beauticode/ProgammableDigitalDisplay/media/photo.jpg

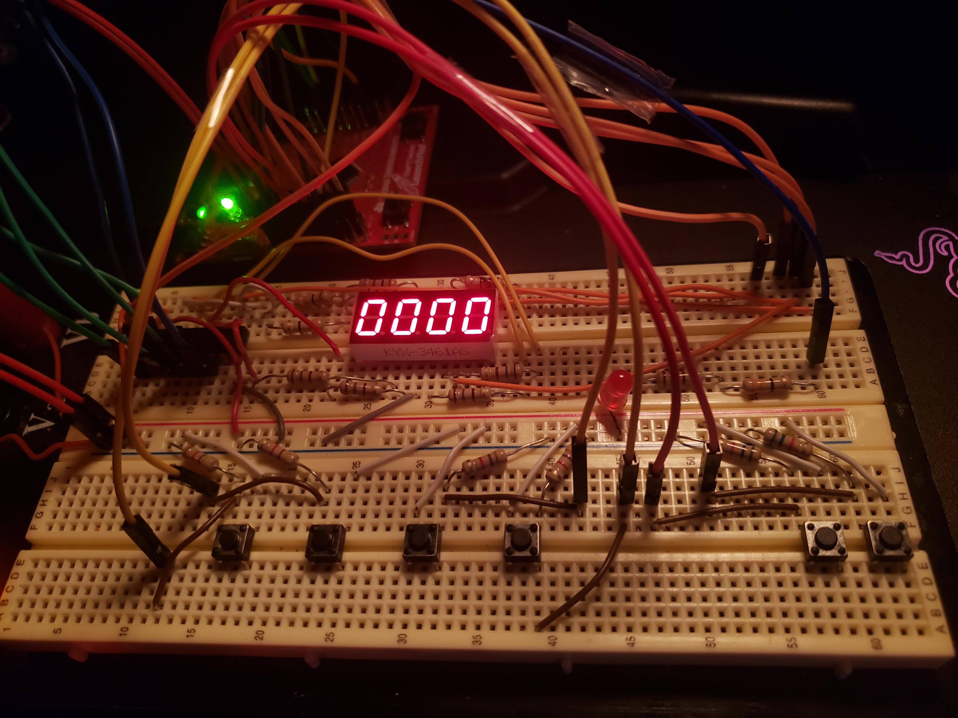
media/photo.jpg
