beauticode/ProgammableDigitalDisplay/README.md

# ProgammableDigitalDisplay
A 4-digit 7-segment display with ability to scroll through characters a-z/0-9 (via buttons) and save each set to be played back in sequence. Utilized the ARM Cortex M4 mcu on the Tiva C Launchpad dev board. Embedded C code and schematic included.
See PDDProject.pdf for detailed info.
Video: https://www.youtube.com/watch?v=TJX261i9BM8
