beauticode/ProgammableDigitalDisplay/schematic/schematic_wdriver.sch

## EAGLE design schematic/schematic_wdriver.sch (2021-03-07)

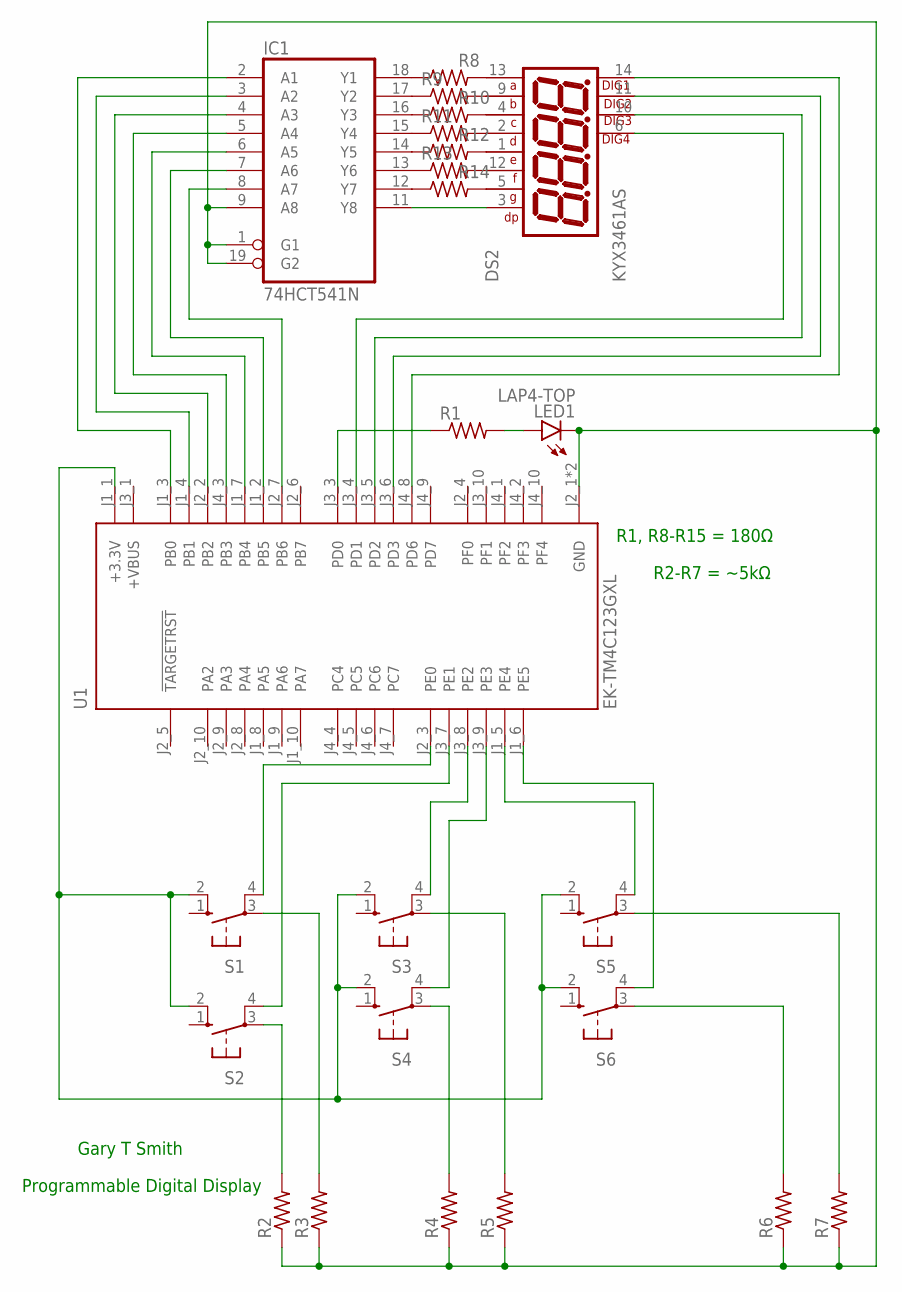
[picture p4: schematic schematic_wdriver.sch]

Parts:
DS2: KYX3461AS; DISPLAY_KYX3461AS
IC1: 74HCT541N; DIL20
LED1: LAP4-TOP; P47F-TOP
R1, R2, R3, R4, R5, R6, R7, R8, R9, R10, R11, R12, R13, R14: R-US_0204/2V; 0204V
S1, S2, S3, S4, S5, S6: 10-XX; B3F-10XX
U1: EK-TM4C123GXL; MODULE_EK-TM4C123GXL

Connections:
unnamed: IC1.18 (Y1), R8.1
unnamed: R1.1, U1.J3_3 (PD0)
unnamed: IC1.8 (A7), U1.J2_7 (PB6)
unnamed: IC1.13 (Y6), R13.1
unnamed: IC1.6 (A5), U1.J1_7 (PB4)
unnamed: IC1.5 (A4), U1.J4_3 (PB3)
unnamed: IC1.4 (A3), U1.J2_2 (PB2)
unnamed: IC1.3 (A2), U1.J1_4 (PB1)
unnamed: DS2.12 (F), R13.2, R14.1
unnamed: DS2.6 (DIG4), U1.J3_4 (PD1)
unnamed: DS2.10 (DIG3), U1.J3_5 (PD2)
unnamed: DS2.11 (DIG2), U1.J3_6 (PD3)
unnamed: DS2.14 (DIG1), U1.J4_8 (PD6)
unnamed: LED1.A, R1.2
unnamed: DS2.5 (G), IC1.12 (Y7), R14.2
unnamed: S6.4 (P1), U1.J1_6 (PE5)
unnamed: S1.2 (S1), S2.2 (S1), S3.2 (S1), S4.2 (S1), S5.2 (S1), S6.2 (S1), U1.J1_1 (+3.3V)
unnamed: S5.4 (P1), U1.J1_5 (PE4)
unnamed: S1.4 (P1), U1.J2_3 (PE0)
unnamed: S2.4 (P1), U1.J3_7 (PE1)
unnamed: S3.4 (P1), U1.J3_8 (PE2)
unnamed: S4.4 (P1), U1.J3_9 (PE3)
unnamed: DS2.1 (E), IC1.14 (Y5), R12.1, R12.2
unnamed: R6.2, S6.3
unnamed: R7.2, S5.3
unnamed: R3.2, S1.3
unnamed: R2.2, S2.3
unnamed: R4.2, S4.3
unnamed: R5.2, S3.3
unnamed: IC1.2 (A1), U1.J1_3 (PB0)
unnamed: DS2.13 (A), R8.2
unnamed: DS2.3 (DP), IC1.11 (Y8)
unnamed: DS2.2 (D), IC1.15 (Y4), R11.1, R11.2
unnamed: IC1.7 (A6), U1.J1_2 (PB5)
unnamed: DS2.4 (C), IC1.16 (Y3), R10.1, R10.2
unnamed: DS2.9 (B), IC1.17 (Y2), R9.1, R9.2
unnamed: IC1.1 (G1), IC1.9 (A8), IC1.19 (G2), LED1.C, R2.1, R3.1, R4.1, R5.1, R6.1, R7.1, U1.J2_1 (GND)

Notes on the sheet:
Gary T Smith
Programmable Digital Display
R1, R8-R15 = 180Ω
R2-R7 = ~5kΩ
